kuba2k2/PiVI/hardware/v1.0/PiVI_v1.0-3d.jpg

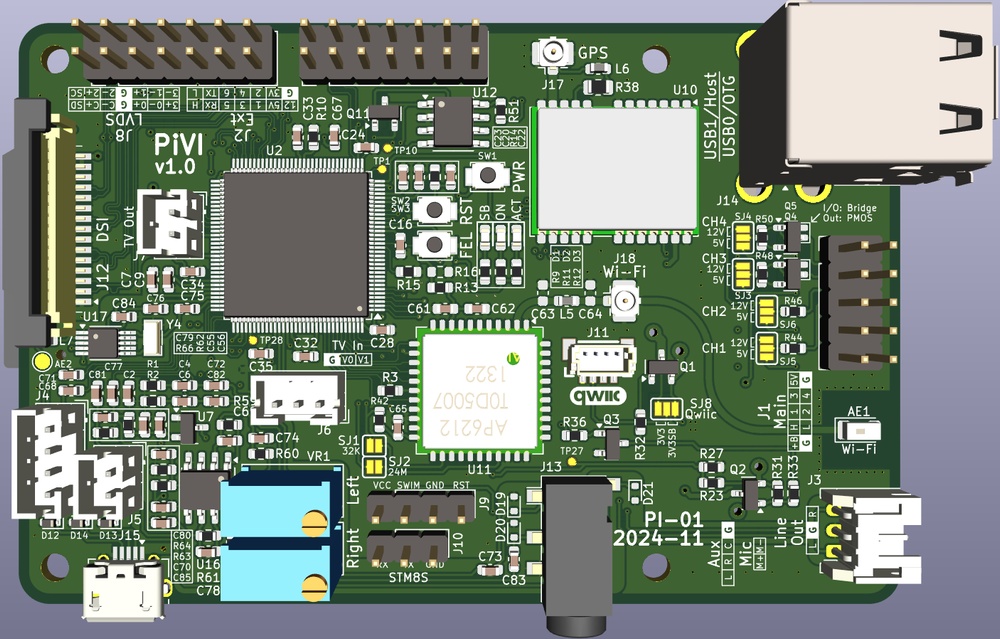
hardware/v1.0/PiVI_v1.0-3d.jpg
