kuba2k2/PiVI/hardware/v1.0/PiVI_v1.0-sch-sheet2-Power.png

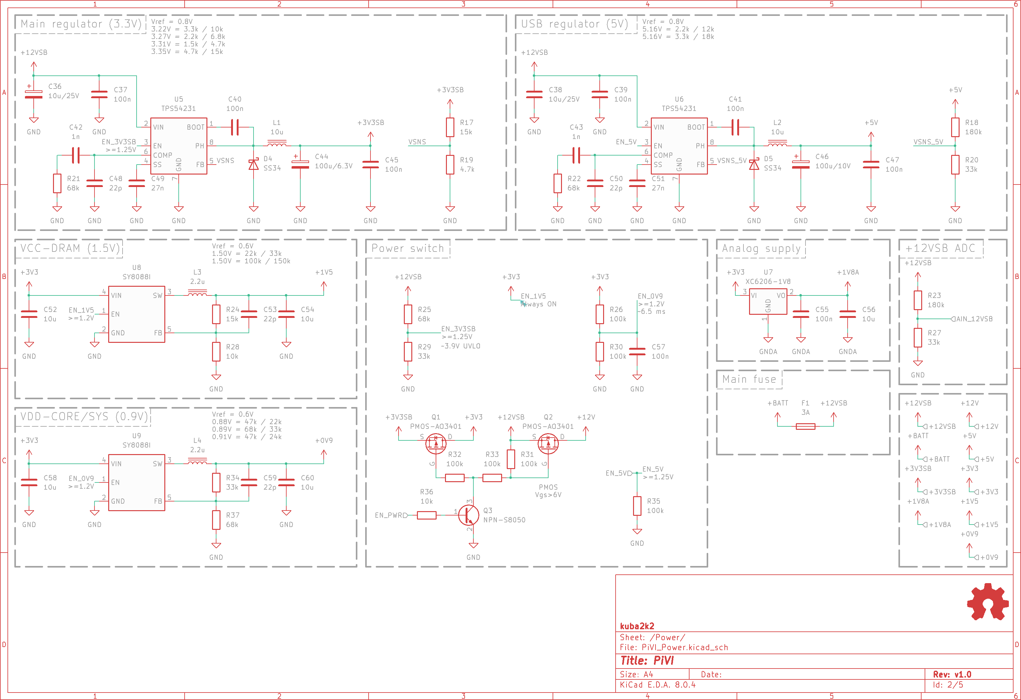
hardware/v1.0/PiVI_v1.0-sch-sheet2-Power.png
