kuba2k2/PiVI/hardware/v1.0/PiVI_v1.0-sch-sheet3-Comms.png

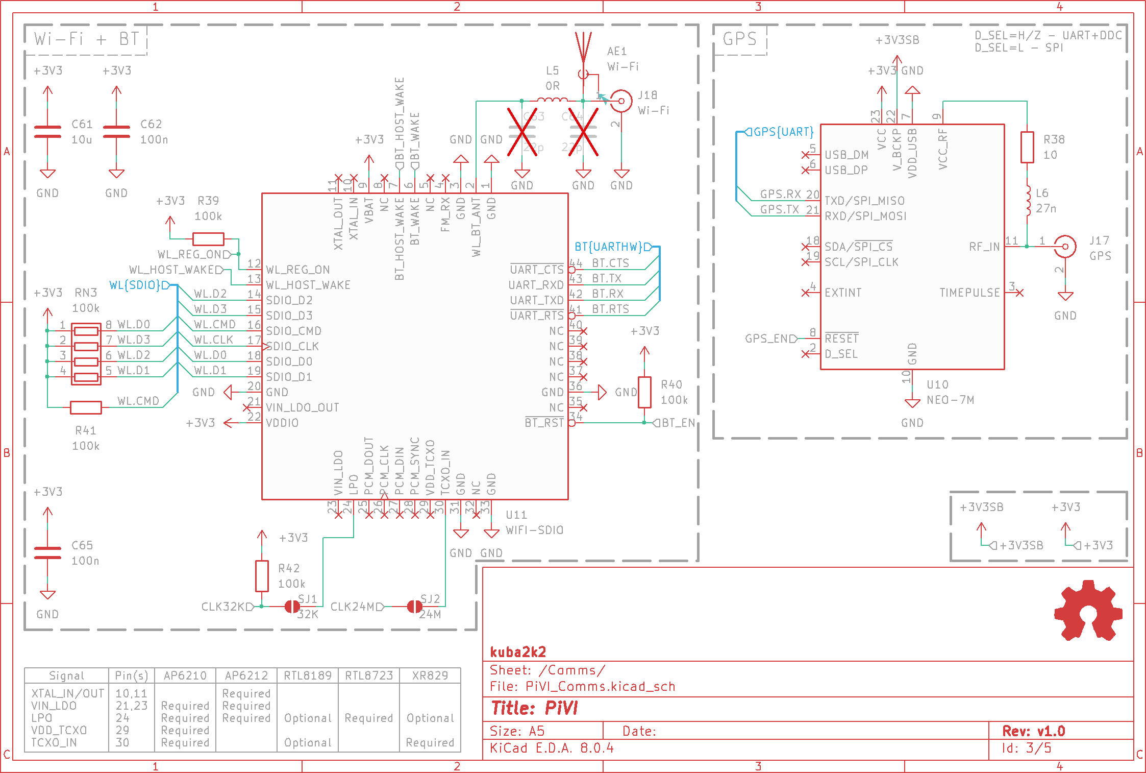
hardware/v1.0/PiVI_v1.0-sch-sheet3-Comms.png
