kuba2k2/PiVI/hardware/v1.0/PiVI_v1.0-sch-sheet5-AV.png

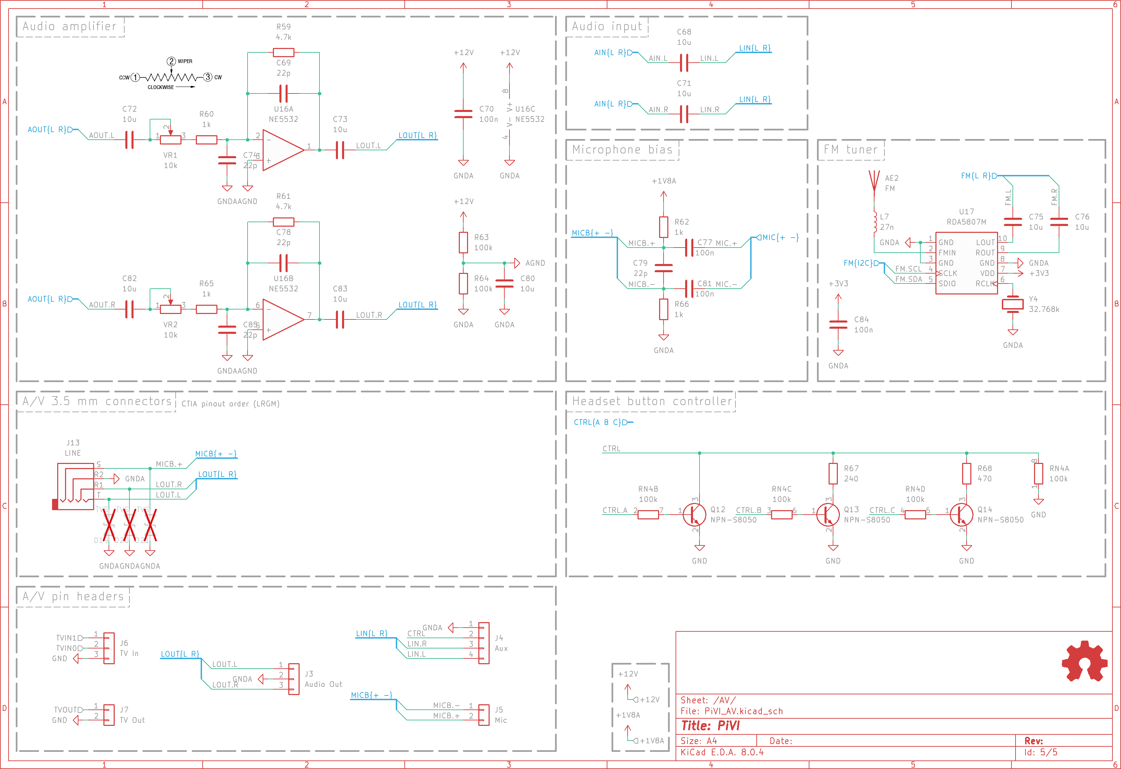
hardware/v1.0/PiVI_v1.0-sch-sheet5-AV.png
