kuba2k2/PiVI/hardware/PiVI.kicad_pcb

## KiCad design hardware/PiVI.kicad_pcb (2025-01-29)

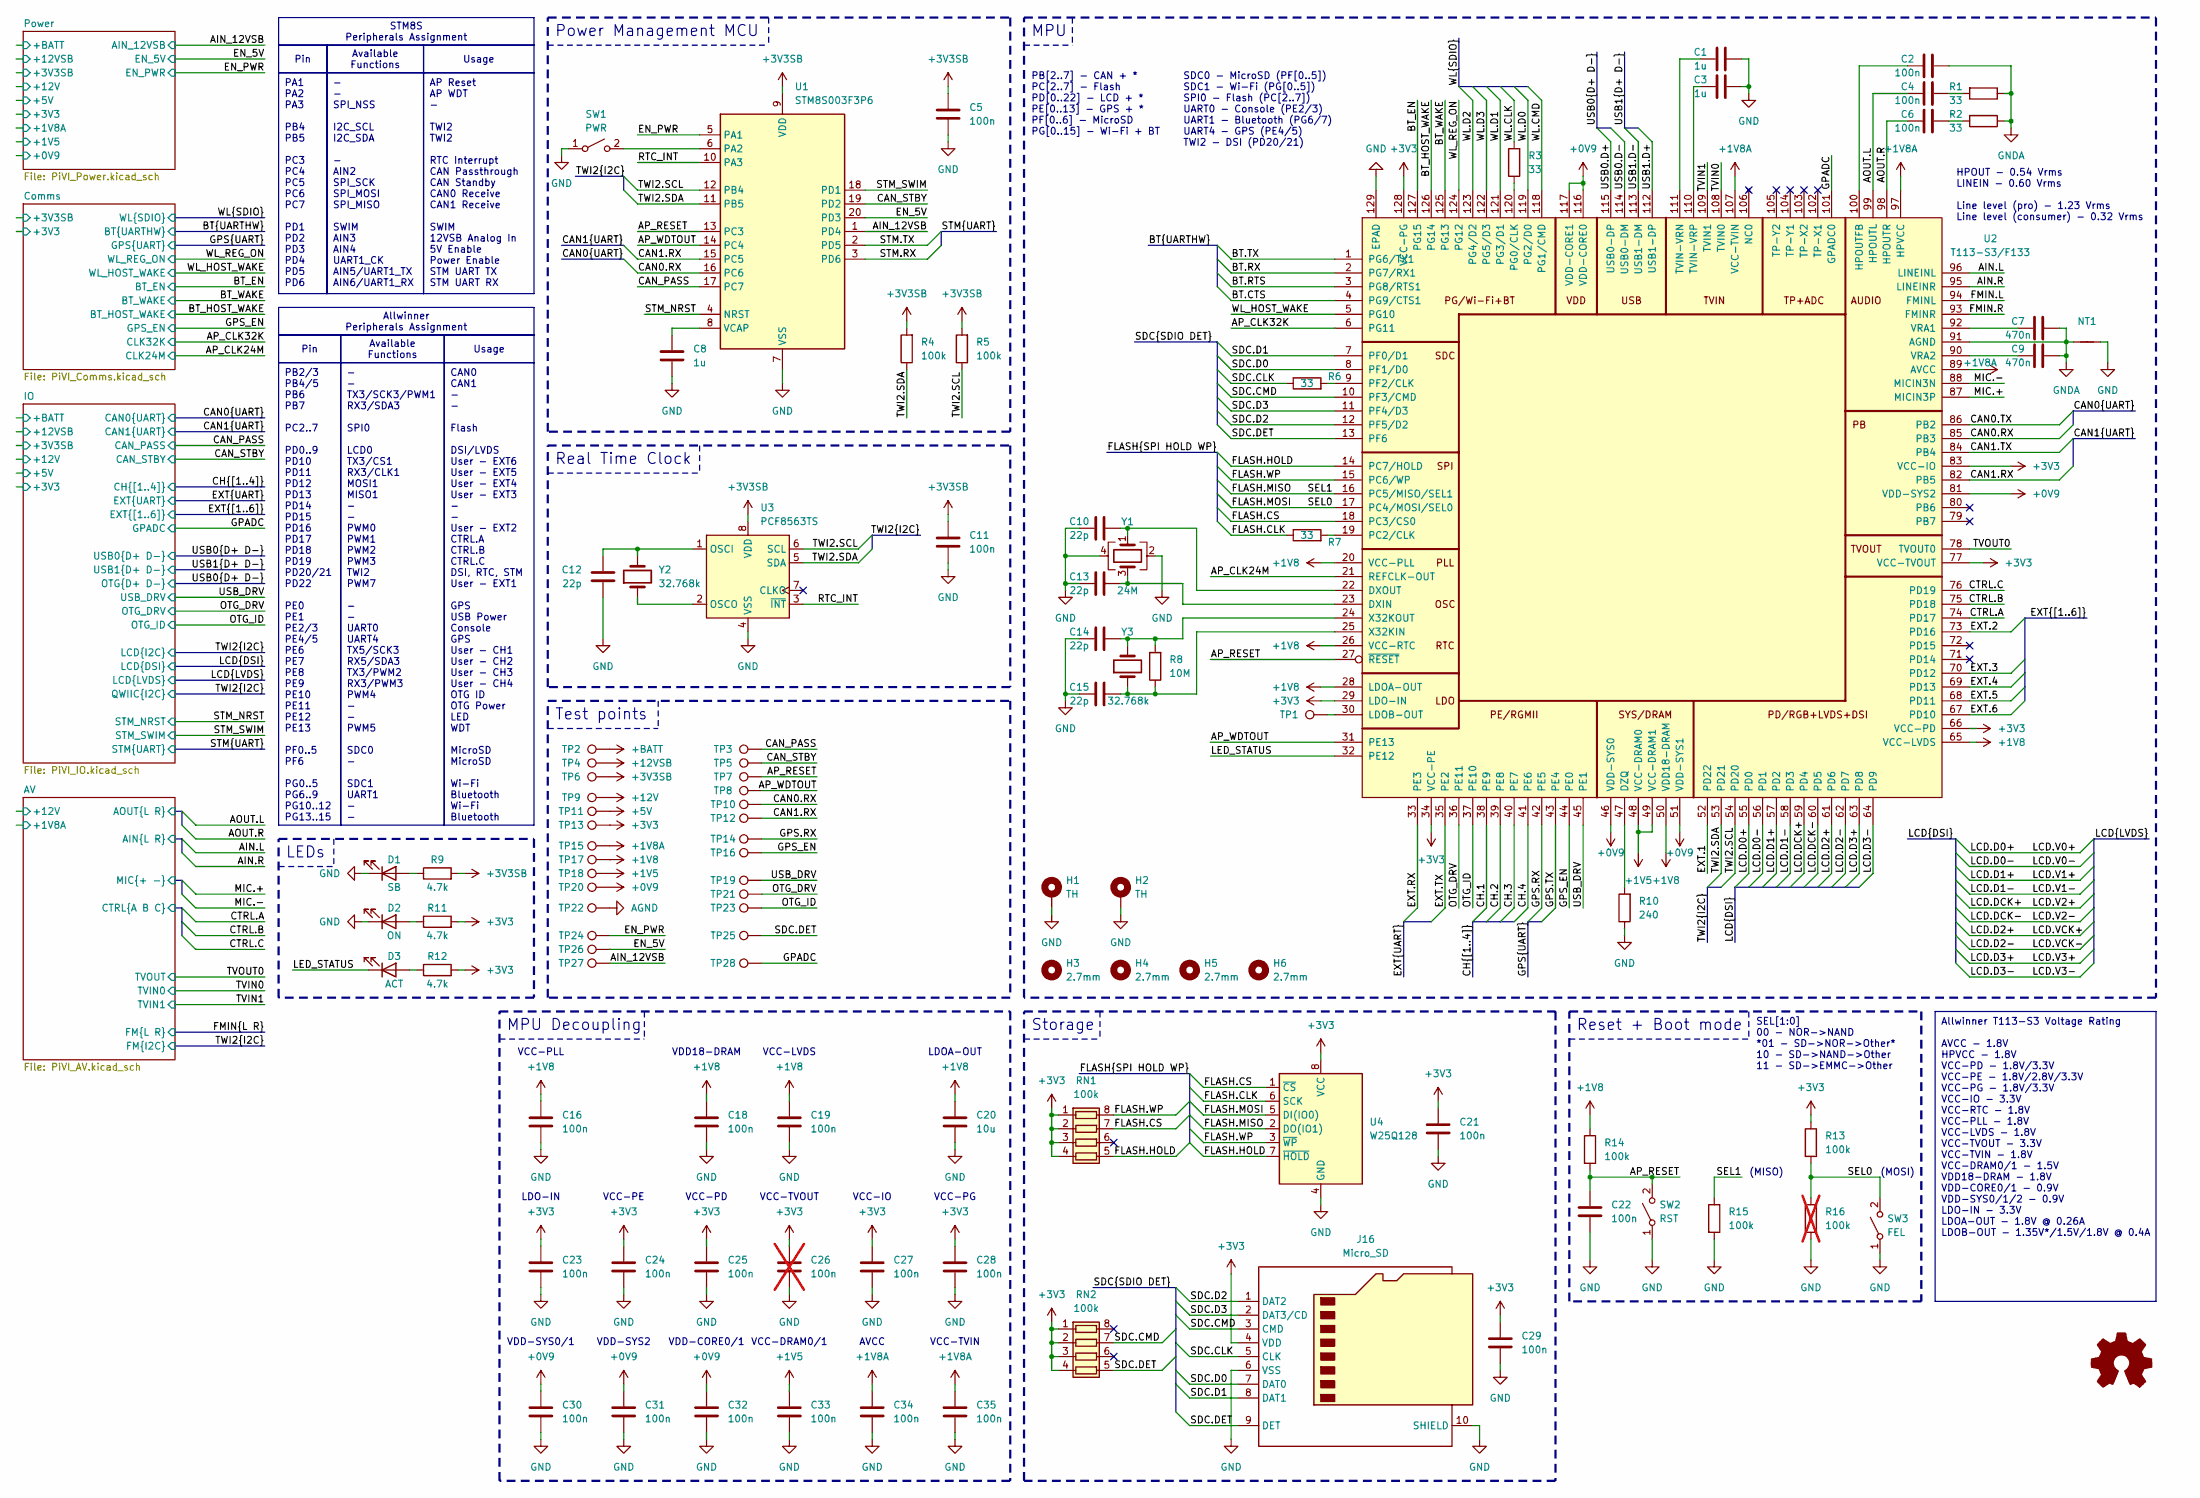
[picture p7: schematic PiVI.kicad_sch]

Parts:
C1, C3, C8: 1u; C_0603_1608Metric; MPN C29936
C2, C4, C5, C6, C11, C16, C18, C19, C21, C22, C23, C24, C25, C27, C28, C29, C30, C31, C32, C33, C34, C35: 100n; C_0603_1608Metric; MPN C14663
C7, C9: 470n; C_0603_1608Metric; MPN C1623
C10, C12, C13, C14, C15: 22p; C_0603_1608Metric; MPN C105620
C20: 10u; C_0603_1608Metric; MPN C19702
C26: 100n; C_0603_1608Metric; MPN C14663; not fitted
D1: SB; LED_0603_1608Metric; MPN C965800
D2: ON; LED_0603_1608Metric; MPN C965799
D3: ACT; LED_0603_1608Metric; MPN C965804
G1: Logo_Open_Hardware_Small; OSHW-Logo_7.5x8mm_SilkScreen; MPN N/A
H1, H2: TH; ThermalVia_1.5mm; MPN N/A
H3, H4, H5, H6: 2.7mm; MountingHole_2.7mm; MPN N/A
J16: Micro_SD; microSD_External_Pin; MPN C393941
NT1: NetTie-2_SMD_Pad0.5mm; MPN N/A
R1, R2, R3, R6, R7: 33; R_0603_1608Metric; MPN C2907154
R4, R5, R13, R14, R15: 100k; R_0603_1608Metric; MPN C2907088
R8: 10M; R_0603_1608Metric; MPN C2907090
R9, R11, R12: 4.7k; R_0603_1608Metric; MPN C2907166
R10: 240; R_0603_1608Metric; MPN C2907130
R16: 100k; R_0603_1608Metric; MPN C2907088; not fitted
RN1, RN2: 100k; R_Array_Convex_4x0603; MPN C173315
SW1: PWR; SW_SPST_B3U-1000P; MPN C455281
SW2: RST; SW_SPST_B3U-1000P; MPN C455281
SW3: FEL; SW_SPST_B3U-1000P; MPN C455281
TP1: LDOB-OUT; TestPoint-0.75mm; MPN N/A
TP2: +BATT; TestPoint-0.75mm; MPN N/A
TP3: CAN_PASS; TestPoint-0.75mm; MPN N/A
TP4: +12SB; TestPoint-0.75mm; MPN N/A
TP5: CAN_STBY; TestPoint-0.75mm; MPN N/A
TP6: +3V3SB; TestPoint-0.75mm; MPN N/A
TP7: AP_RESET; TestPoint-0.75mm; MPN N/A
TP8: AP_WDTOUT; TestPoint-0.75mm; MPN N/A
TP9: +12V; TestPoint-0.75mm; MPN N/A
TP10: CAN0.RX; TestPoint-0.75mm; MPN N/A
TP11: +5V; TestPoint-0.75mm; MPN N/A
TP12: CAN1.RX; TestPoint-0.75mm; MPN N/A
TP13: +3V3; TestPoint-0.75mm; MPN N/A
TP14: GPS.RX; TestPoint-0.75mm; MPN N/A
TP15: +1V8A; TestPoint-0.75mm; MPN N/A
TP16: GPS_EN; TestPoint-0.75mm; MPN N/A
TP17: +1V8; TestPoint-0.75mm; MPN N/A
TP18: +1V5; TestPoint-0.75mm; MPN N/A
TP19: USB_DRV; TestPoint-0.75mm; MPN N/A
TP20: +0V9; TestPoint-0.75mm; MPN N/A
TP21: OTG_DRV; TestPoint-0.75mm; MPN N/A
TP22: AGND; TestPoint-0.75mm; MPN N/A
TP23: OTG_ID; TestPoint-0.75mm; MPN N/A
TP24: EN_PWR; TestPoint-0.75mm; MPN N/A
TP25: SDC.DET; TestPoint-0.75mm; MPN N/A
TP26: EN_5V; TestPoint-0.75mm; MPN N/A
TP27: AIN_12SB; TestPoint-0.75mm; MPN N/A
TP28: GPADC; TestPoint-0.75mm; MPN N/A
U1: STM8S003F3P6; TSSOP-20_4.4x6.5mm_P0.65mm; MPN C52717
U2: T113-S3/F133; eLQFP-128_14x14mm_P0.4mm; MPN C5197687/C22438485
U3: PCF8563TS; MSOP-8_3x3mm_P0.65mm; MPN C269878
U4: W25Q128; SOIC-8_5.275x5.275mm_P1.27mm; MPN C97521
Y1: 24M; Crystal_SMD_3225-4Pin_3.2x2.5mm; MPN C70590
Y2, Y3: 32.768k; Crystal_SMD_3215-2Pin_3.2x1.5mm; MPN C5361379

Connections:
+0V9: C30.1, C31.1, C32.1, TP20.1, U2.46 (VDD-SYS0), U2.51 (VDD-SYS1), U2.81 (VDD-SYS2), U2.116 (VDD-CORE0), U2.117 (VDD-CORE1); also elsewhere on the board
+1V5: C33.1, TP18.1, U2.48 (VCC-DRAM0), U2.49 (VCC-DRAM1); also elsewhere on the board
+1V8: C16.1, C18.1, C19.1, C20.1, R14.1, TP17.1, U2.20 (VCC-PLL), U2.26 (VCC-RTC), U2.28 (LDOA-OUT), U2.50 (VDD18-DRAM), U2.65 (VCC-LVDS)
+1V8A: C34.1, C35.1, TP15.1, U2.89 (AVCC), U2.97 (HPVCC), U2.107 (VCC-TVIN); also elsewhere on the board
+3V3: C21.1, C23.1, C24.1, C25.1, C26.1, C27.1, C28.1, C29.1, J16.4 (VDD), R11.2, R12.2, R13.1, RN1.1 (R1.1), RN1.2 (R2.1), RN1.3 (R3.1), RN1.4 (R4.1), RN2.1 (R1.1), RN2.2 (R2.1), RN2.3 (R3.1), RN2.4 (R4.1), TP13.1, U2.29 (LDO-IN), U2.34 (VCC-PE), U2.66 (VCC-PD), U2.77 (VCC-TVOUT), U2.83 (VCC-IO), U2.128 (VCC-PG), U4.8 (VCC); also elsewhere on the board
+3V3SB: C5.1, C11.1, R4.2, R5.2, R9.2, TP6.1, U1.9 (VDD), U3.8 (VDD); also elsewhere on the board
+5V: TP11.1; also elsewhere on the board
+12V: TP9.1; also elsewhere on the board
+12VSB: TP4.1; also elsewhere on the board
+BATT: TP2.1; also elsewhere on the board
/AIN_12VSB: TP27.1, U1.1 (PD4); also elsewhere on the board
/AP_CLK24M: U2.21 (REFCLK-OUT); also elsewhere on the board
/AP_CLK32K: U2.6 (PG11); also elsewhere on the board
/AP_RESET: C22.2, R14.2, SW2.2 (B), TP7.1, U1.13 (PC3), U2.27 (~RESET)
/AP_WDTOUT: TP8.1, U1.14 (PC4), U2.31 (PE13)
/AV/AIN.L: U2.96 (LINEINL); also elsewhere on the board
/AV/AIN.R: U2.95 (LINEINR); also elsewhere on the board
/AV/AOUT.L: C4.2, U2.99 (HPOUTL); also elsewhere on the board
/AV/AOUT.R: C6.2, U2.98 (HPOUTR); also elsewhere on the board
/AV/CTRL.A: U2.74 (PD17); also elsewhere on the board
/AV/CTRL.B: U2.75 (PD18); also elsewhere on the board
/AV/CTRL.C: U2.76 (PD19); also elsewhere on the board
/AV/MIC.+: U2.87 (MICIN3P); also elsewhere on the board
/AV/MIC.-: U2.88 (MICIN3N); also elsewhere on the board
/BT.CTS: U2.4 (PG9/CTS1); also elsewhere on the board
/BT.RTS: U2.3 (PG8/RTS1); also elsewhere on the board
/BT.RX: U2.2 (PG7/RX1); also elsewhere on the board
/BT.TX: U2.1 (PG6/TX1); also elsewhere on the board
/BT_EN: U2.127 (PG15); also elsewhere on the board
/BT_HOST_WAKE: U2.126 (PG14); also elsewhere on the board
/BT_WAKE: U2.125 (PG13); also elsewhere on the board
/CAN0.RX: TP10.1, U1.16 (PC6), U2.85 (PB3); also elsewhere on the board
/CAN0.TX: U2.86 (PB2); also elsewhere on the board
/CAN1.RX: TP12.1, U1.15 (PC5), U2.82 (PB5); also elsewhere on the board
/CAN1.TX: U2.84 (PB4); also elsewhere on the board
/CAN_PASS: TP3.1, U1.17 (PC7); also elsewhere on the board
/CAN_STBY: TP5.1, U1.19 (PD2); also elsewhere on the board
/CH.1: U2.38 (PE9); also elsewhere on the board
/CH.2: U2.39 (PE8); also elsewhere on the board
/CH.3: U2.40 (PE7); also elsewhere on the board
/CH.4: U2.41 (PE6); also elsewhere on the board
/EN_5V: TP26.1, U1.20 (PD3); also elsewhere on the board
/EN_PWR: TP24.1, U1.5 (PA1); also elsewhere on the board
/EXT.1: U2.52 (PD22); also elsewhere on the board
/EXT.2: U2.73 (PD16); also elsewhere on the board
/EXT.3: U2.70 (PD12); also elsewhere on the board
/EXT.4: U2.69 (PD13); also elsewhere on the board
/EXT.5: U2.68 (PD11); also elsewhere on the board
/EXT.6: U2.67 (PD10); also elsewhere on the board
/EXT.RX: U2.33 (PE3); also elsewhere on the board
/EXT.TX: U2.35 (PE2); also elsewhere on the board
/FLASH.CLK: R7.1, U4.6 (SCK)
/FLASH.CS: RN1.7 (R2.2), U2.18 (PC3/CS0), U4.1 (~CS)
/FLASH.HOLD: RN1.5 (R4.2), U2.14 (PC7/HOLD), U4.7 (~HOLD)
/FLASH.MISO: R15.1, U2.16 (PC5/MISO/SEL1), U4.2 (DO(IO1))
/FLASH.MOSI: R13.2, R16.1, SW3.2 (B), U2.17 (PC4/MOSI/SEL0), U4.5 (DI(IO0))
/FLASH.WP: RN1.8 (R1.2), U2.15 (PC6/WP), U4.3 (~WP)
/FMIN.L: U2.94 (FMINL); also elsewhere on the board
/FMIN.R: U2.93 (FMINR); also elsewhere on the board
/GPADC: TP28.1, U2.101 (GPADC0)
/GPS.RX: TP14.1, U2.42 (PE5); also elsewhere on the board
/GPS.TX: U2.43 (PE4); also elsewhere on the board
/GPS_EN: TP16.1, U2.44 (PE0); also elsewhere on the board
/LCD.V0+: U2.55 (PD0); also elsewhere on the board
/LCD.V0-: U2.56 (PD1); also elsewhere on the board
/LCD.V1+: U2.57 (PD2); also elsewhere on the board
/LCD.V1-: U2.58 (PD3); also elsewhere on the board
/LCD.V2+: U2.59 (PD4); also elsewhere on the board
/LCD.V2-: U2.60 (PD5); also elsewhere on the board
/LCD.V3+: U2.63 (PD8); also elsewhere on the board
/LCD.V3-: U2.64 (PD9); also elsewhere on the board
/LCD.VCK+: U2.61 (PD6); also elsewhere on the board
/LCD.VCK-: U2.62 (PD7); also elsewhere on the board
/LED_STATUS: D3.1 (K), U2.32 (PE12)
/OTG_DRV: TP21.1, U2.36 (PE11); also elsewhere on the board
/OTG_ID: TP23.1, U2.37 (PE10); also elsewhere on the board
/RTC_INT: U1.10 (PA3), U3.3 (~INT)
/SDC.CLK: J16.5 (CLK), R6.1
/SDC.CMD: J16.3 (CMD), RN2.7 (R2.2), U2.10 (PF3/CMD)
/SDC.D0: J16.7 (DAT0), U2.8 (PF1/D0)
/SDC.D1: J16.8 (DAT1), U2.7 (PF0/D1)
/SDC.D2: J16.1 (DAT2), U2.12 (PF5/D2)
/SDC.D3: J16.2 (DAT3/CD), U2.11 (PF4/D3)
/SDC.DET: J16.9 (DET), RN2.5 (R4.2), TP25.1, U2.13 (PF6)
/STM.RX: U1.3 (PD6); also elsewhere on the board
/STM.TX: U1.2 (PD5); also elsewhere on the board
/STM_NRST: U1.4 (NRST); also elsewhere on the board
/STM_SWIM: U1.18 (PD1); also elsewhere on the board
/TVIN0: U2.108 (TVIN0); also elsewhere on the board
/TVIN1: U2.109 (TVIN1); also elsewhere on the board
/TVOUT0: U2.78 (TVOUT0); also elsewhere on the board
/USB1.D+: U2.112 (USB1-DP); also elsewhere on the board
/USB1.D-: U2.113 (USB1-DM); also elsewhere on the board
/USB_DRV: TP19.1, U2.45 (PE1); also elsewhere on the board
/WL.CLK: R3.2; also elsewhere on the board
/WL.CMD: U2.118 (PG1/CMD); also elsewhere on the board
/WL.D0: U2.119 (PG2/D0); also elsewhere on the board
/WL.D1: U2.121 (PG3/D1); also elsewhere on the board
/WL.D2: U2.123 (PG4/D2); also elsewhere on the board
/WL.D3: U2.122 (PG5/D3); also elsewhere on the board
/WL_HOST_WAKE: U2.5 (PG10); also elsewhere on the board
/WL_REG_ON: U2.124 (PG12); also elsewhere on the board
AGND: TP22.1; also elsewhere on the board
GND: C1.1, C3.1, C5.2, C8.1, C10.1, C11.2, C12.1, C13.1, C14.1, C15.1, C16.2, C18.2, C19.2, C20.2, C21.2, C22.1, C23.2, C24.2, C25.2, C26.2, C27.2, C28.2, C29.2, C30.2, C31.2, C32.2, C33.2, C34.2, C35.2, D1.1 (K), D2.1 (K), H1.1, H2.1, J16.6 (VSS), J16.10 (SHIELD), NT1.2, R10.1, R15.2, R16.2, SW1.1 (A), SW2.1 (A), SW3.1 (A), U1.7 (VSS), U2.129 (EPAD), U3.4 (VSS), U4.4 (GND), Y1.2, Y1.4; also elsewhere on the board
GNDA: C2.1, C7.2, C9.2, NT1.1, R1.1, R2.1, U2.91 (AGND); also elsewhere on the board
unnamed: C4.1, R1.2
unnamed: C6.1, R2.2
unnamed: D1.2 (A), R9.1
unnamed: D2.2 (A), R11.1
unnamed: D3.2 (A), R12.1
unnamed: SW1.2 (B), U1.6 (PA2)
unnamed: C8.2, U1.8 (VCAP)
unnamed: C13.2, U2.23 (DXIN), Y1.3
unnamed: C10.2, U2.22 (DXOUT), Y1.1
unnamed: R10.2, U2.47 (DZQ)
unnamed: C2.2, U2.100 (HPOUTFB)
unnamed: TP1.1, U2.30 (LDOB-OUT)
unnamed: R7.2, U2.19 (PC2/CLK)
unnamed: R6.2, U2.9 (PF2/CLK)
unnamed: R3.1, U2.120 (PG0/CLK)
unnamed: C1.2, U2.111 (TVIN-VRN)
unnamed: C3.2, U2.110 (TVIN-VRP)
unnamed: C7.1, U2.92 (VRA1)
unnamed: C9.1, U2.90 (VRA2)
unnamed: C15.2, R8.1, U2.25 (X32KIN), Y3.1
unnamed: C14.2, R8.2, U2.24 (X32KOUT), Y3.2
unnamed: C12.2, U3.1 (OSCI), Y2.2
unnamed: U3.2 (OSCO), Y2.1

Notes on the sheet:
Pin
Usage
- - TX3/SCK3/PWM1 RX3/SDA3 SPI0 LCD0 TX3/CS1 RX3/CLK1 MOSI1 MISO1 - - PWM0 PWM1 PWM2 PWM3 TWI2 PWM7 - - UART0 UART4 TX5/SCK3 RX5/SDA3 TX3/PWM2 RX3/PWM3 PWM4 - - PWM5 SDC0 - SDC1 UART1 - -
AP Reset AP WDT - TWI2 TWI2 RTC Interrupt CAN Passthrough CAN Standby CAN0 Receive CAN1 Receive SWIM 12VSB Analog In 5V Enable Power Enable STM UART TX STM UART RX
- - SPI_NSS I2C_SCL I2C_SDA - AIN2 SPI_SCK SPI_MOSI SPI_MISO SWIM AIN3 AIN4 UART1_CK AIN5/UART1_TX AIN6/UART1_RX
Allwinner T113-S3 Voltage Rating AVCC - 1.8V HPVCC - 1.8V VCC-PD - 1.8V/3.3V VCC-PE - 1.8V/2.8V/3.3V VCC-PG - 1.8V/3.3V VCC-IO - 3.3V VCC-RTC - 1.8V VCC-PLL - 1.8V VCC-LVDS - 1.8V VCC-TVOUT - 3.3V VCC-TVIN - 1.8V VCC-DRAM0/1 - 1.5V VDD18-DRAM - 1.8V VDD-CORE0/1 - 0.9V VDD-SYS0/1/2 - 0.9V LDO-IN - 3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
Available Functions
PA1 PA2 PA3 PB4 PB5 PC3 PC4 PC5 PC6 PC7 PD1 PD2 PD3 PD4 PD5 PD6
PB2/3 PB4/5 PB6 PB7 PC2..7 PD0..9 PD10 PD11 PD12 PD13 PD14 PD15 PD16 PD17 PD18 PD19 PD20/21 PD22 PE0 PE1 PE2/3 PE4/5 PE6 PE7 PE8 PE9 PE10 PE11 PE12 PE13 PF0..5 PF6 PG0..5 PG6..9 PG10..12 PG13..15
CAN0 CAN1 - - Flash DSI/LVDS User - EXT6 User - EXT5 User - EXT4 User - EXT3 - - User - EXT2 CTRL.A CTRL.B CTRL.C DSI, RTC, STM User - EXT1 GPS USB Power Console GPS User - CH1 User - CH2 User - CH3 User - CH4 OTG ID OTG Power LED WDT MicroSD MicroSD Wi-Fi Bluetooth Wi-Fi Bluetooth
STM8S Peripherals Assignment
Allwinner Peripherals Assignment
(MOSI)
SDC0 - MicroSD (PF[0..5]) SDC1 - Wi-Fi (PG[0..5]) SPI0 - Flash (PC[2..7]) UART0 - Console (PE2/3) UART1 - Bluetooth (PG6/7) UART4 - GPS (PE4/5) TWI2 - DSI (PD20/21)
VCC-DRAM0/1
VDD-SYS2
VCC-PE
VCC-PD
LDO-IN
HPOUT - 0.54 Vrms LINEIN - 0.60 Vrms Line level (pro) - 1.23 Vrms Line level (consumer) - 0.32 Vrms
Power Management MCU
SEL[1:0] 00 - NOR->NAND *01 - SD->NOR->Other* 10 - SD->NAND->Other 11 - SD->EMMC->Other
VCC-IO
Storage
VDD-SYS0/1
LEDs
Reset + Boot mode
Real Time Clock
VDD-CORE0/1
VCC-PLL
VCC-TVOUT
VCC-PG
PB[2..7] - CAN + * PC[2..7] - Flash PD[0..22] - LCD + * PE[0..13] - GPS + * PF[0..6] - MicroSD PG[0..15] - Wi-Fi + BT
(MISO)
MPU Decoupling
VCC-LVDS
LDOA-OUT
VCC-TVIN
MPU
Test points
AVCC
VDD18-DRAM

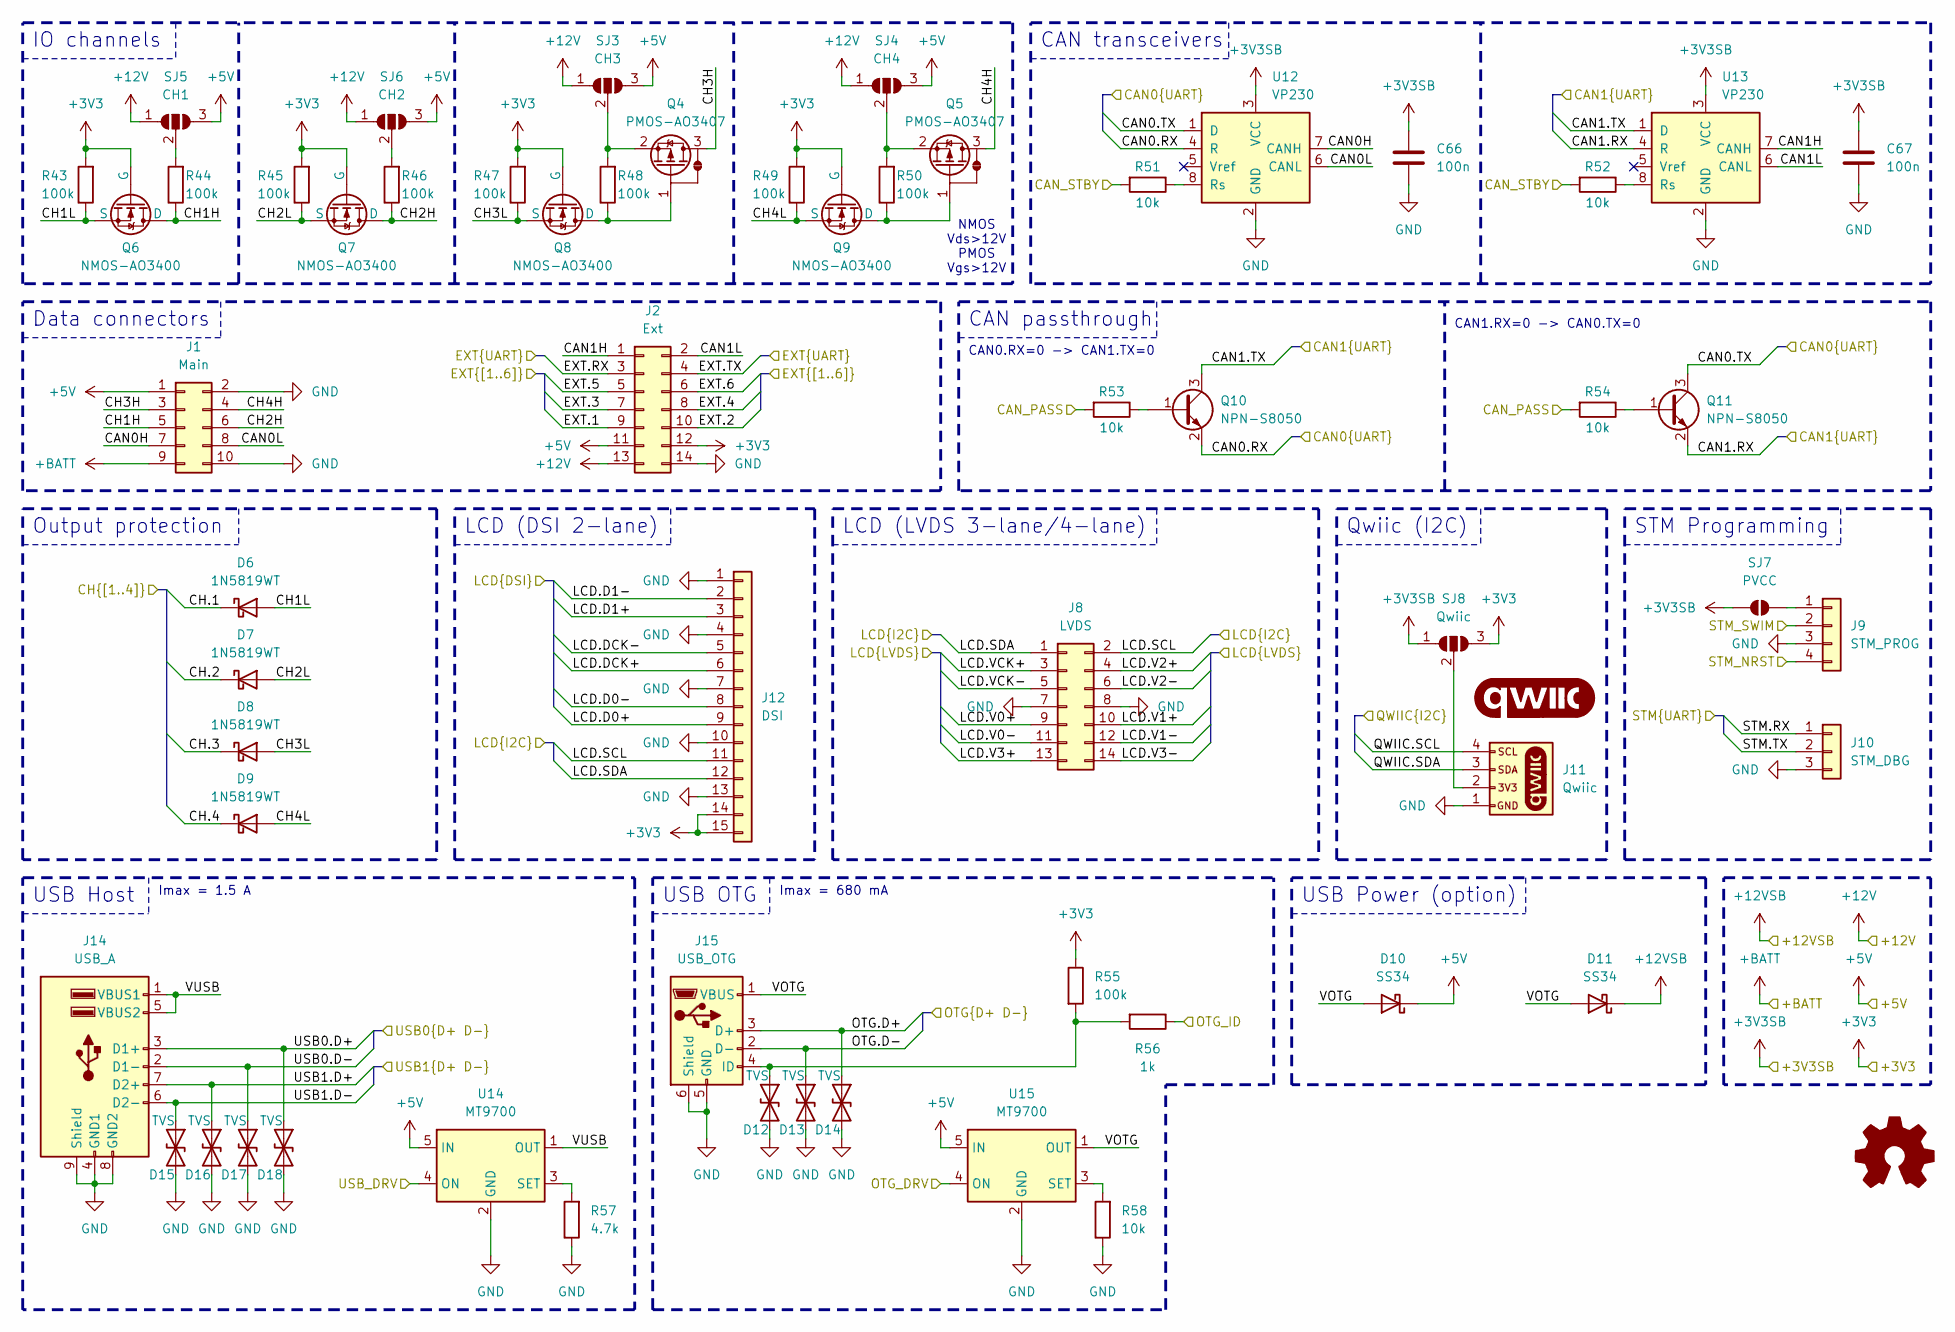
[picture p8: schematic PiVI_IO.kicad_sch, PiVI]

Parts:
C66, C67: 100n; C_0603_1608Metric; MPN C14663
D6, D7, D8, D9: 1N5819WT; D_SOD-523; MPN C5451630
D10, D11: SS34; D_SMA; MPN C2836396
D12, D13, D14, D15, D16, D17, D18: TVS; D_SOD-523; MPN C3008120
G2: qwiic_Logo; qwiic_5.5mm; MPN N/A
J1: Main; PinHeader_2x05_P2.54mm_Vertical; MPN C19190512/C19190511
J2: Ext; PinHeader_2x07_P2.54mm_Vertical; MPN C19190512/C19190511
J8: LVDS; PinHeader_2x07_P2.54mm_Vertical; MPN C19190512/C19190511
J9: STM_PROG; PinHeader_1x04_P2.54mm_Vertical; MPN C2337
J10: STM_DBG; PinHeader_1x03_P2.54mm_Vertical; MPN C2337
J11: Qwiic; JST_SMD_1.0mm-4_Vertical; MPN C160390
J12: DSI; TE-1-1734248-5; MPN C2922285
J14: USB_A; USB_A_CUI_UJ2-ADH-TH_Horizontal_Stacked; MPN C456021
J15: USB_OTG; USB_Micro-B_MicroXNJ; MPN C404969
Q4, Q5: PMOS-AO3407; SOT-23-GDPASS; MPN C347478
Q6, Q7, Q8, Q9: NMOS-AO3400; SOT-23; MPN C20628874
Q10, Q11: NPN-S8050; SOT-23; MPN C181158
R43, R44, R45, R46, R47, R48, R49, R50, R55: 100k; R_0603_1608Metric; MPN C2907088
R51, R52, R53, R54, R58: 10k; R_0603_1608Metric; MPN C2930027
R56: 1k; R_0603_1608Metric; MPN C2907113
R57: 4.7k; R_0603_1608Metric; MPN C2907166
SJ3: CH3; Jumper_3_NO; MPN N/A
SJ4: CH4; Jumper_3_NO; MPN N/A
SJ5: CH1; Jumper_3_NO; MPN N/A
SJ6: CH2; Jumper_3_NO; MPN N/A
SJ7: PVCC; Jumper_2_NO; MPN N/A
SJ8: Qwiic; Jumper_3_NO; MPN N/A
U12, U13: VP230; SOIC-8_3.9x4.9mm_P1.27mm; MPN C12084
U14, U15: MT9700; SOT-23-5; MPN C89855

Connections:
+3V3: J2.12, J12.14, J12.15, Q6.1 (G), Q7.1 (G), Q8.1 (G), Q9.1 (G), R43.2, R45.2, R47.2, R49.2, R55.1, SJ8.3 (B); also elsewhere on the board
+3V3SB: C66.1, C67.1, SJ7.1 (A), SJ8.1 (A), U12.3 (VCC), U13.3 (VCC); also elsewhere on the board
+5V: D10.1 (K), J1.1, J2.11, SJ3.3 (B), SJ4.3 (B), SJ5.3 (B), SJ6.3 (B), U14.5 (IN), U15.5 (IN); also elsewhere on the board
+12V: J2.13, SJ3.1 (A), SJ4.1 (A), SJ5.1 (A), SJ6.1 (A); also elsewhere on the board
+12VSB: D11.1 (K); also elsewhere on the board
+BATT: J1.9; also elsewhere on the board
/CAN0.RX: Q10.2 (E), U12.4 (R); also elsewhere on the board
/CAN0.TX: Q11.3 (C), U12.1 (D); also elsewhere on the board
/CAN1.RX: Q11.2 (E), U13.4 (R); also elsewhere on the board
/CAN1.TX: Q10.3 (C), U13.1 (D); also elsewhere on the board
/CAN_PASS: R53.2, R54.2; also elsewhere on the board
/CAN_STBY: R51.2, R52.2; also elsewhere on the board
/CH.1: D6.1 (K); also elsewhere on the board
/CH.2: D7.1 (K); also elsewhere on the board
/CH.3: D8.1 (K); also elsewhere on the board
/CH.4: D9.1 (K); also elsewhere on the board
/EXT.1: J2.9; also elsewhere on the board
/EXT.2: J2.10; also elsewhere on the board
/EXT.3: J2.7; also elsewhere on the board
/EXT.4: J2.8; also elsewhere on the board
/EXT.5: J2.5; also elsewhere on the board
/EXT.6: J2.6; also elsewhere on the board
/EXT.RX: J2.3; also elsewhere on the board
/EXT.TX: J2.4; also elsewhere on the board
/IO/CAN0H: J1.7, U12.7 (CANH)
/IO/CAN0L: J1.8, U12.6 (CANL)
/IO/CAN1H: J2.1, U13.7 (CANH)
/IO/CAN1L: J2.2, U13.6 (CANL)
/IO/CH1H: J1.5, Q6.3 (D), R44.1
/IO/CH1L: D6.2 (A), Q6.2 (S), R43.1
/IO/CH2H: J1.6, Q7.3 (D), R46.1
/IO/CH2L: D7.2 (A), Q7.2 (S), R45.1
/IO/CH3H: J1.3, Q4.3 (D)
/IO/CH3L: D8.2 (A), Q8.2 (S), R47.1
/IO/CH4H: J1.4, Q5.3 (D)
/IO/CH4L: D9.2 (A), Q9.2 (S), R49.1
/IO/VOTG: D10.2 (A), D11.2 (A), J15.1 (VBUS), U15.1 (OUT)
/IO/VUSB: J14.1 (VBUS1), J14.5 (VBUS2), U14.1 (OUT)
/LCD.V0+: J8.9, J12.9; also elsewhere on the board
/LCD.V0-: J8.11, J12.8; also elsewhere on the board
/LCD.V1+: J8.10, J12.3; also elsewhere on the board
/LCD.V1-: J8.12, J12.2; also elsewhere on the board
/LCD.V2+: J8.4, J12.6; also elsewhere on the board
/LCD.V2-: J8.6, J12.5; also elsewhere on the board
/LCD.V3+: J8.13; also elsewhere on the board
/LCD.V3-: J8.14; also elsewhere on the board
/LCD.VCK+: J8.3; also elsewhere on the board
/LCD.VCK-: J8.5; also elsewhere on the board
/OTG_DRV: U15.4 (ON); also elsewhere on the board
/OTG_ID: R56.1; also elsewhere on the board
/STM.RX: J10.1; also elsewhere on the board
/STM.TX: J10.2; also elsewhere on the board
/STM_NRST: J9.4; also elsewhere on the board
/STM_SWIM: J9.2; also elsewhere on the board
/USB1.D+: D16.1 (A1), J14.7 (D2+); also elsewhere on the board
/USB1.D-: D15.1 (A1), J14.6 (D2-); also elsewhere on the board
/USB_DRV: U14.4 (ON); also elsewhere on the board
GND: C66.2, C67.2, D12.2 (A2), D13.2 (A2), D14.2 (A2), D15.2 (A2), D16.2 (A2), D17.2 (A2), D18.2 (A2), J1.2, J1.10, J2.14, J8.7, J8.8, J9.3, J10.3, J11.1, J12.1, J12.4, J12.7, J12.10, J12.13, J14.4 (GND1), J14.8 (GND2), J14.9 (Shield), J15.5 (GND), J15.6 (Shield), R57.1, R58.1, U12.2 (GND), U13.2 (GND), U14.2 (GND), U15.2 (GND); also elsewhere on the board
unnamed: D12.1 (A1), J15.4 (ID), R55.2, R56.2
unnamed: J9.1, SJ7.2 (B)
unnamed: J11.2, SJ8.2 (C)
unnamed: Q4.1 (G), Q8.3 (D), R48.1
unnamed: Q4.2 (S), R48.2, SJ3.2 (C)
unnamed: Q5.1 (G), Q9.3 (D), R50.1
unnamed: Q5.2 (S), R50.2, SJ4.2 (C)
unnamed: Q10.1 (B), R53.1
unnamed: Q11.1 (B), R54.1
unnamed: R44.2, SJ5.2 (C)
unnamed: R46.2, SJ6.2 (C)
unnamed: R51.1, U12.8 (Rs)
unnamed: R52.1, U13.8 (Rs)
unnamed: R57.2, U14.3 (SET)
unnamed: R58.2, U15.3 (SET)

Notes on the sheet:
USB Host
Imax = 680 mA
LCD (LVDS 3-lane/4-lane)
CAN transceivers
Data connectors
USB OTG
CAN1.RX=0 -> CAN0.TX=0
Imax = 1.5 A
LCD (DSI 2-lane)
STM Programming
Output protection
IO channels
NMOS Vds>12V PMOS Vgs>12V
CAN passthrough
Qwiic (I2C)
CAN0.RX=0 -> CAN1.TX=0
USB Power (option)

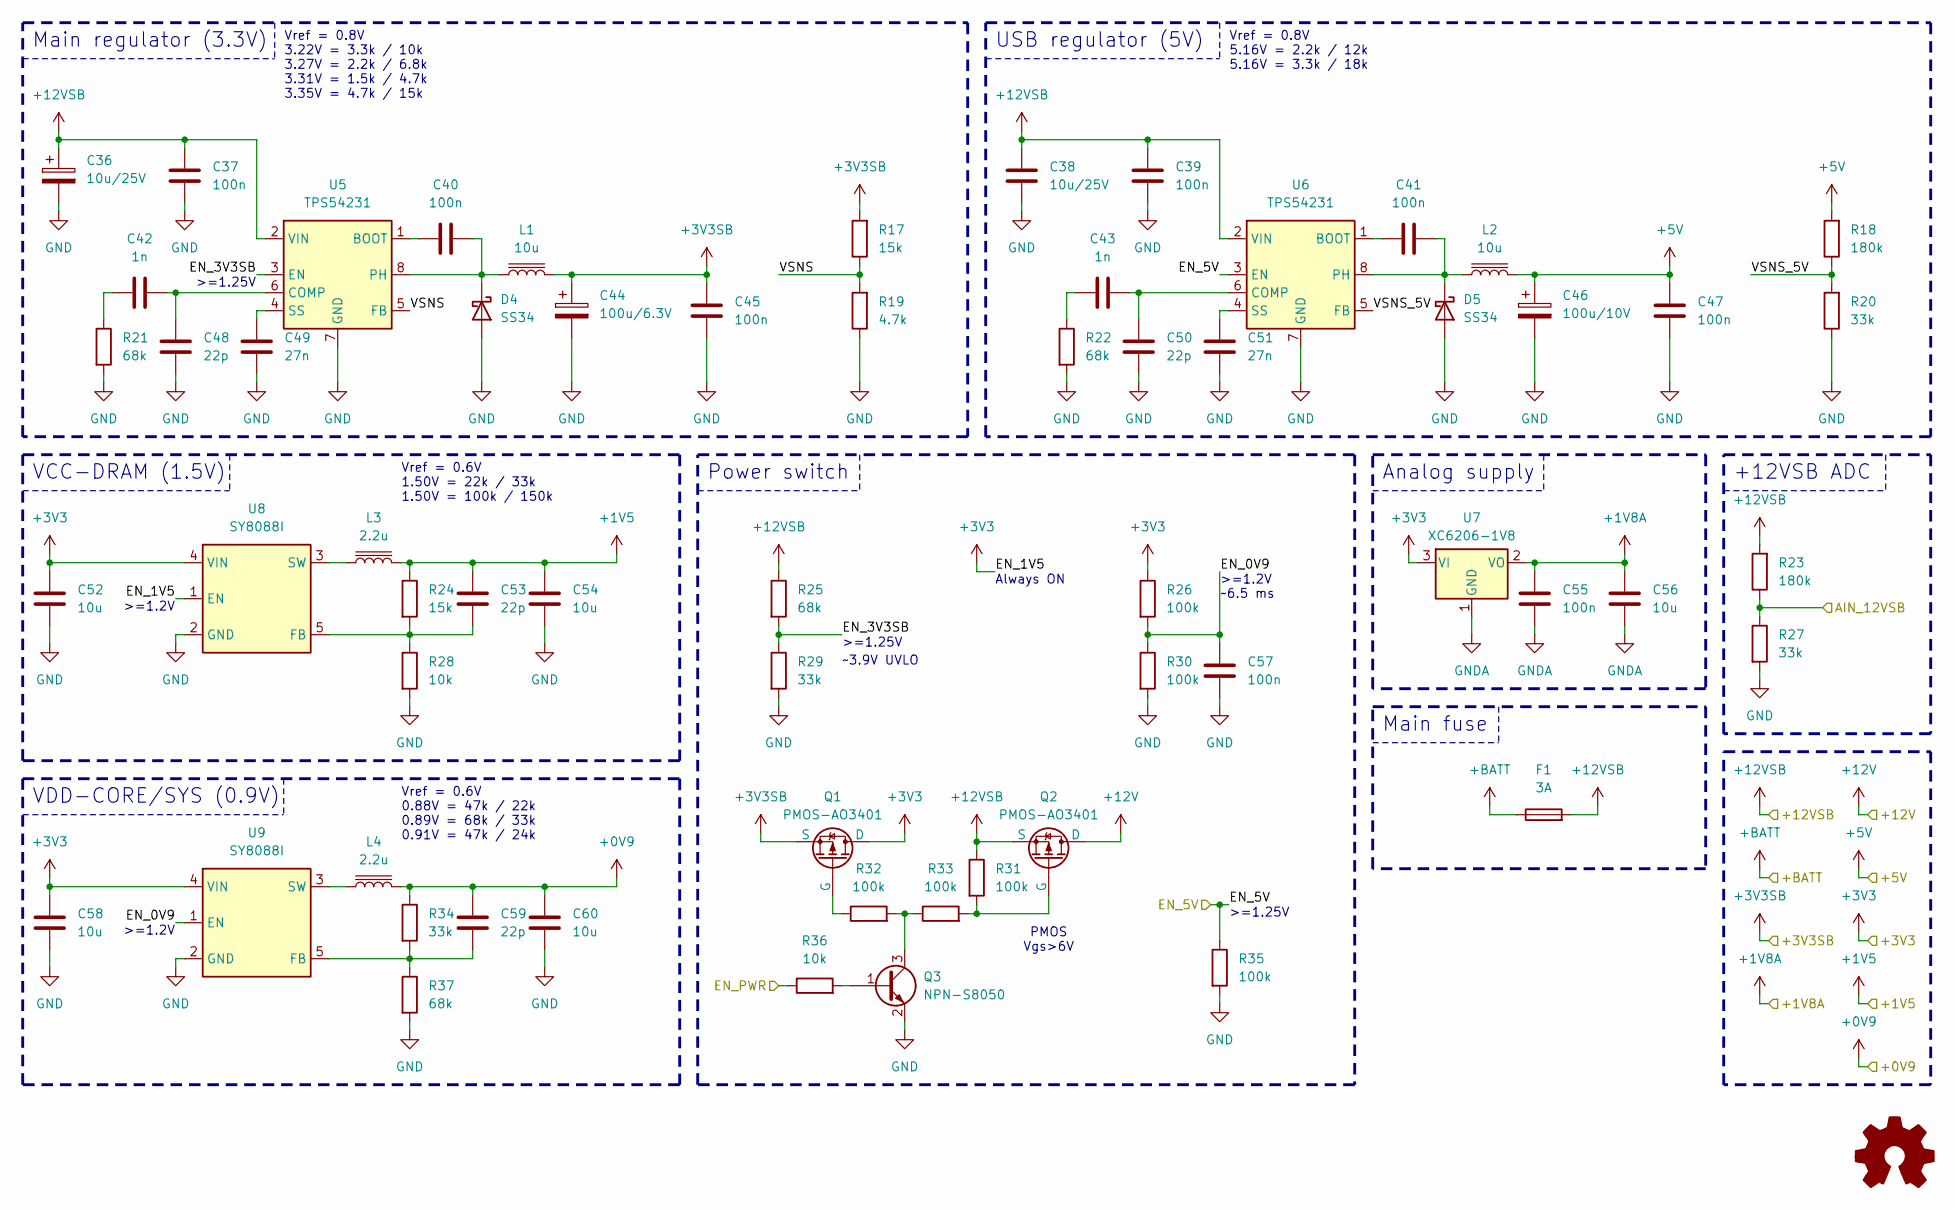
[picture p9: schematic PiVI_Power.kicad_sch, PiVI]

Parts:
C36: 10u/25V; CP_EIA-3528-21_Kemet-B; MPN C119050
C37, C39, C40, C41, C45, C47, C55, C57: 100n; C_0603_1608Metric; MPN C14663
C38: 10u/25V; C_0805_2012Metric; MPN C15850
C42, C43: 1n; C_0603_1608Metric; MPN C100040
C44: 100u/6.3V; CP_EIA-3528-21_Kemet-B; MPN C129289
C46: 100u/10V; CP_EIA-3528-21_Kemet-B; MPN C129567
C48, C50, C53, C59: 22p; C_0603_1608Metric; MPN C105620
C49, C51: 27n; C_0603_1608Metric; MPN C107086
C52, C54, C56, C58, C60: 10u; C_0603_1608Metric; MPN C19702
D4, D5: SS34; D_SMA; MPN C2836396
F1: 3A; Fuse_1206_3216Metric; MPN C14165
L1, L2: 10u; L_Changjiang_FNR4020S; MPN C602032
L3, L4: 2.2u; L_Sunlord_SWPA3015S; MPN C43389
Q1, Q2: PMOS-AO3401; SOT-23; MPN C20628875
Q3: NPN-S8050; SOT-23; MPN C181158
R17, R24: 15k; R_0603_1608Metric; MPN C2907104
R18, R23: 180k; R_0603_1608Metric; MPN C2907109
R19: 4.7k; R_0603_1608Metric; MPN C2907166
R20, R27, R29, R34: 33k; R_0603_1608Metric; MPN C2907153
R21, R22, R25, R37: 68k; R_0603_1608Metric; MPN C2907196
R26, R30, R31, R32, R33, R35: 100k; R_0603_1608Metric; MPN C2907088
R28, R36: 10k; R_0603_1608Metric; MPN C2930027
U5, U6: TPS54231; SOIC-8_3.9x4.9mm_P1.27mm; MPN C28023
U7: XC6206-1V8; SOT-23-3; MPN C5252894
U8, U9: SY8088I; TSOT-23-5; MPN C479072

Connections:
+0V9: C59.1, C60.1, L4.2, R34.1; also elsewhere on the board
+1V5: C53.1, C54.1, L3.2, R24.1; also elsewhere on the board
+1V8A: C55.1, C56.1, U7.2 (VO); also elsewhere on the board
+3V3: C52.1, C58.1, Q1.3 (D), R26.1, U7.3 (VI), U8.1 (EN), U8.4 (VIN), U9.4 (VIN); also elsewhere on the board
+3V3SB: C44.1, C45.1, L1.2, Q1.2 (S), R17.2; also elsewhere on the board
+5V: C46.1, C47.1, L2.2, R18.2; also elsewhere on the board
+12V: Q2.3 (D); also elsewhere on the board
+12VSB: C36.1, C37.1, C38.1, C39.1, F1.2, Q2.2 (S), R23.2, R25.1, R31.1, U5.2 (VIN), U6.2 (VIN); also elsewhere on the board
+BATT: F1.1; also elsewhere on the board
/AIN_12VSB: R23.1, R27.1; also elsewhere on the board
/EN_5V: R35.1, U6.3 (EN); also elsewhere on the board
/EN_PWR: R36.1; also elsewhere on the board
/Power/EN_0V9: C57.1, R26.2, R30.1, U9.1 (EN)
/Power/EN_3V3SB: R25.2, R29.1, U5.3 (EN)
/Power/VSNS: R17.1, R19.2, U5.5 (FB)
/Power/VSNS_5V: R18.1, R20.2, U6.5 (FB)
GND: C36.2, C37.2, C38.2, C39.2, C44.2, C45.2, C46.2, C47.2, C48.2, C49.2, C50.2, C51.2, C52.2, C54.2, C57.2, C58.2, C60.2, D4.2 (A), D5.2 (A), Q3.2 (E), R19.1, R20.1, R21.2, R22.2, R27.2, R28.2, R29.2, R30.2, R35.2, R37.2, U5.7 (GND), U6.7 (GND), U8.2 (GND), U9.2 (GND); also elsewhere on the board
GNDA: C55.2, C56.2, U7.1 (GND); also elsewhere on the board
unnamed: C42.2, R21.1
unnamed: C43.2, R22.1
unnamed: C40.2, D4.1 (K), L1.1, U5.8 (PH)
unnamed: C41.2, D5.1 (K), L2.1, U6.8 (PH)
unnamed: Q1.1 (G), R32.1
unnamed: Q2.1 (G), R31.2, R33.2
unnamed: Q3.1 (B), R36.2
unnamed: Q3.3 (C), R32.2, R33.1
unnamed: C40.1, U5.1 (BOOT)
unnamed: C42.1, C48.1, U5.6 (COMP)
unnamed: C49.1, U5.4 (SS)
unnamed: C41.1, U6.1 (BOOT)
unnamed: C43.1, C50.1, U6.6 (COMP)
unnamed: C51.1, U6.4 (SS)
unnamed: C53.2, R24.2, R28.1, U8.5 (FB)
unnamed: L3.1, U8.3 (SW)
unnamed: C59.2, R34.2, R37.1, U9.5 (FB)
unnamed: L4.1, U9.3 (SW)

Notes on the sheet:
>=1.2V
Analog supply
USB regulator (5V)
Main regulator (3.3V)
>=1.25V
VDD-CORE/SYS (0.9V)
VCC-DRAM (1.5V)
~3.9V UVLO
PMOS Vgs>6V
Main fuse
Vref = 0.8V 5.16V = 2.2k / 12k 5.16V = 3.3k / 18k
Power switch
Always ON
Vref = 0.6V 1.50V = 22k / 33k 1.50V = 100k / 150k
Vref = 0.8V 3.22V = 3.3k / 10k 3.27V = 2.2k / 6.8k 3.31V = 1.5k / 4.7k 3.35V = 4.7k / 15k
~6.5 ms
+12VSB ADC
Vref = 0.6V 0.88V = 47k / 22k 0.89V = 68k / 33k 0.91V = 47k / 24k
