kuba2k2/PiVI/hardware/PiVI.kicad_pcb

## KiCad design hardware/PiVI.kicad_pcb (continued)

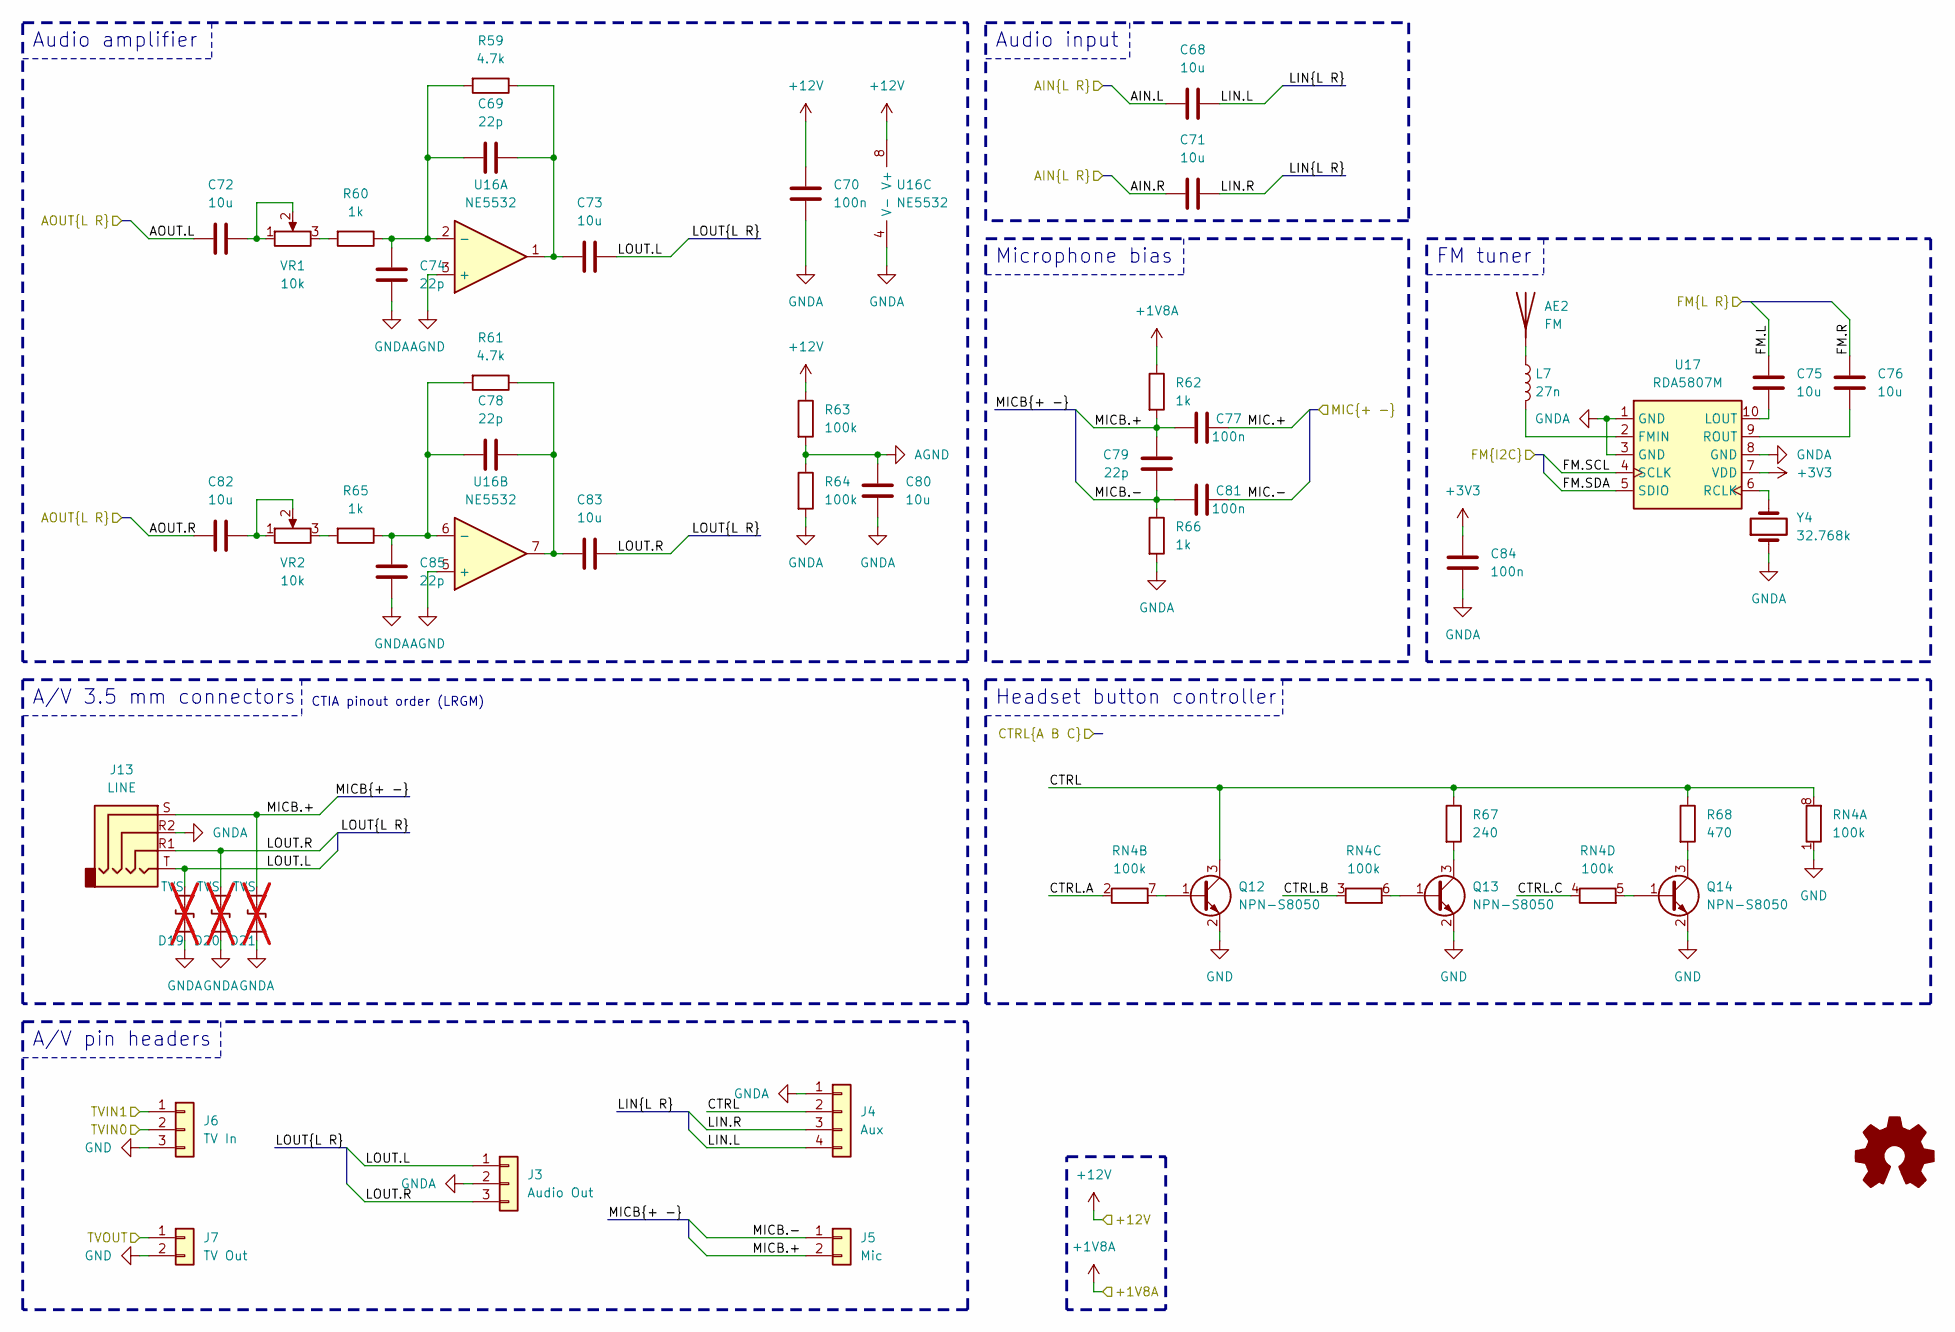
[picture p10: schematic PiVI_AV.kicad_sch, PiVI]

Parts:
AE2: FM; TestPoint_Pad_D1.5mm; MPN N/A
C68, C71, C72, C73, C75, C76, C80, C82, C83: 10u; C_0603_1608Metric; MPN C19702
C69, C74, C78, C79, C85: 22p; C_0603_1608Metric; MPN C105620
C70, C77, C81, C84: 100n; C_0603_1608Metric; MPN C14663
D19, D20, D21: TVS; D_SOD-523; MPN C3008120; not fitted
J3: Audio Out; JST_PH_S3B-PH-K_1x03_P2.00mm_Horizontal; MPN C157929
J4: Aux; JST_PH_B4B-PH-K_1x04_P2.00mm_Vertical; MPN C131334
J5: Mic; JST_PH_B2B-PH-K_1x02_P2.00mm_Vertical; MPN C131337
J6: TV In; JST_PH_B3B-PH-K_1x03_P2.00mm_Vertical; MPN C131339
J7: TV Out; JST_PH_B2B-PH-K_1x02_P2.00mm_Vertical; MPN C131337
J13: LINE; Jack_3.5mm_PJ320D_Horizontal; MPN C431535
L7: 27n; L_0603_1608Metric; MPN C12100
Q12, Q13, Q14: NPN-S8050; SOT-23; MPN C181158
R59, R61: 4.7k; R_0603_1608Metric; MPN C2907166
R60, R62, R65, R66: 1k; R_0603_1608Metric; MPN C2907113
R63, R64: 100k; R_0603_1608Metric; MPN C2907088
R67: 240; R_0603_1608Metric; MPN C2907130
R68: 470; R_0603_1608Metric; MPN C2907172
RN4: 100k; R_Array_Convex_4x0603; MPN C173315
U16: NE5532; SOIC-8_3.9x4.9mm_P1.27mm; MPN C7426
U17: RDA5807M; MSOP-10_3x3mm_P0.5mm
VR1, VR2: 10k; Potentiometer_Bourns_3296W_Vertical; MPN C118954
Y4: 32.768k; Crystal_SMD_3215-2Pin_3.2x1.5mm; MPN C5361379

Connections:
+1V8A: R62.1; also elsewhere on the board
+3V3: C84.1, U17.7 (VDD); also elsewhere on the board
+12V: C70.1, R63.1, U16.8 (V+); also elsewhere on the board
/AV/AIN.L: C68.1; also elsewhere on the board
/AV/AIN.R: C71.1; also elsewhere on the board
/AV/AOUT.L: C72.1; also elsewhere on the board
/AV/AOUT.R: C82.1; also elsewhere on the board
/AV/CTRL: J4.2, Q12.3 (C), R67.1, R68.1, RN4.8 (R1.2)
/AV/CTRL.A: RN4.2 (R2.1); also elsewhere on the board
/AV/CTRL.B: RN4.3 (R3.1); also elsewhere on the board
/AV/CTRL.C: RN4.4 (R4.1); also elsewhere on the board
/AV/LIN.L: C68.2, J4.4
/AV/LIN.R: C71.2, J4.3
/AV/LOUT.L: C73.2, D19.1 (A1), J3.1, J13.T
/AV/LOUT.R: C83.2, D20.1 (A1), J3.3, J13.R1
/AV/MIC.+: C77.2; also elsewhere on the board
/AV/MIC.-: C81.2; also elsewhere on the board
/AV/MICB.+: C77.1, C79.1, D21.1 (A1), J5.2, J13.S, R62.2
/AV/MICB.-: C79.2, C81.1, J5.1, R66.1
/FMIN.L: C75.1; also elsewhere on the board
/FMIN.R: C76.1; also elsewhere on the board
/TVIN0: J6.2; also elsewhere on the board
/TVIN1: J6.1; also elsewhere on the board
/TVOUT0: J7.1; also elsewhere on the board
AGND: C80.1, R63.2, R64.1, U16.3 (+), U16.5 (+); also elsewhere on the board
GND: J6.3, J7.2, Q12.2 (E), Q13.2 (E), Q14.2 (E), RN4.1 (R1.1); also elsewhere on the board
GNDA: C70.2, C74.2, C80.2, C84.2, C85.2, D19.2 (A2), D20.2 (A2), D21.2 (A2), J3.2, J4.1, J13.R2, R64.2, R66.2, U16.4 (V-), U17.1 (GND), U17.3 (GND), U17.8 (GND), Y4.1; also elsewhere on the board
unnamed: AE2.1 (A), L7.1
unnamed: C69.2, C73.1, R59.1, U16.1
unnamed: C72.2, VR1.1, VR1.2
unnamed: C78.2, C83.1, R61.1, U16.7
unnamed: C82.2, VR2.1, VR2.2
unnamed: Q12.1 (B), RN4.7 (R2.2)
unnamed: Q13.1 (B), RN4.6 (R3.2)
unnamed: Q13.3 (C), R67.2
unnamed: Q14.1 (B), RN4.5 (R4.2)
unnamed: Q14.3 (C), R68.2
unnamed: R60.2, VR1.3
unnamed: R65.2, VR2.3
unnamed: C69.1, C74.1, R59.2, R60.1, U16.2 (-)
unnamed: C78.1, C85.1, R61.2, R65.1, U16.6 (-)
unnamed: L7.2, U17.2 (FMIN)
unnamed: C75.2, U17.10 (LOUT)
unnamed: U17.6 (RCLK), Y4.2
unnamed: C76.2, U17.9 (ROUT)

Notes on the sheet:
CTIA pinout order (LRGM)
Audio amplifier
Audio input
FM tuner
Headset button controller
A/V 3.5 mm connectors
A/V pin headers
Microphone bias

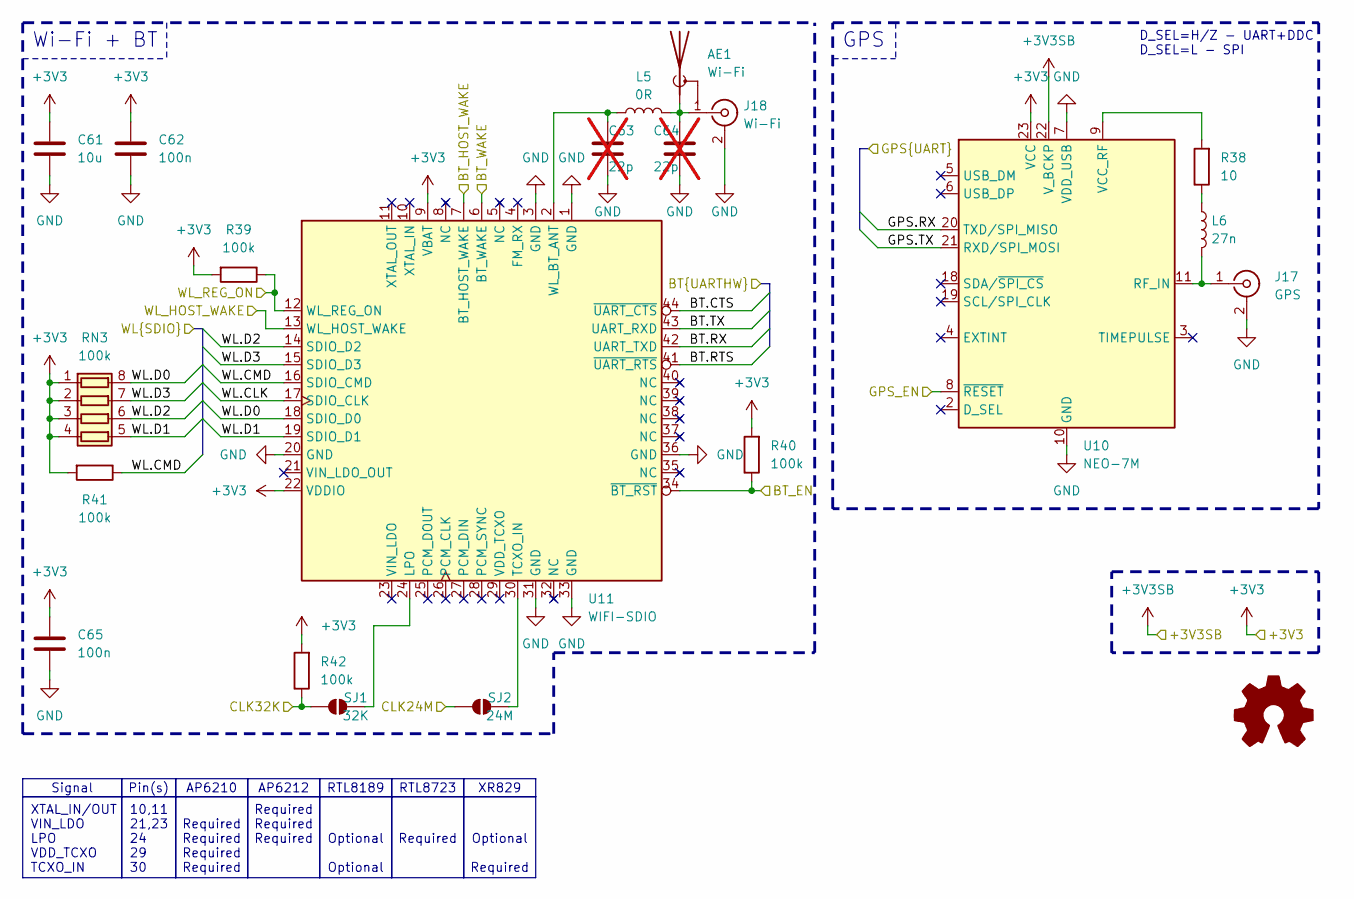
[picture p11: schematic PiVI_Comms.kicad_sch, PiVI]

Parts:
AE1: Wi-Fi; Johanson_2450AT18x100; MPN C127629
C61: 10u; C_0603_1608Metric; MPN C19702
C62, C65: 100n; C_0603_1608Metric; MPN C14663
C63, C64: 22p; C_0603_1608Metric; MPN C105620; not fitted
J17: GPS; U.FL_Hirose_U.FL-R-SMT-1_Vertical; MPN C5137195
J18: Wi-Fi; U.FL_Hirose_U.FL-R-SMT-1_Vertical; MPN C5137195
L5: 0R; L_0603_1608Metric
L6: 27n; L_0603_1608Metric; MPN C12100
R38: 10; R_0805_2012Metric; MPN C2907296
R39, R40, R41, R42: 100k; R_0603_1608Metric; MPN C2907088
RN3: 100k; R_Array_Convex_4x0603; MPN C173315
SJ1: 32K; Jumper_2_NO; MPN N/A
SJ2: 24M; Jumper_2_NO; MPN N/A
U10: NEO-7M; ublox_NEO
U11: WIFI-SDIO; WiFi_SDIO_44-pin

Connections:
+3V3: C61.1, C62.1, C65.1, R39.2, R40.2, R41.2, R42.2, RN3.1 (R1.1), RN3.2 (R2.1), RN3.3 (R3.1), RN3.4 (R4.1), U10.23 (VCC), U11.9 (VBAT), U11.22 (VDDIO); also elsewhere on the board
+3V3SB: U10.22 (V_BCKP); also elsewhere on the board
/AP_CLK24M: SJ2.1 (A); also elsewhere on the board
/AP_CLK32K: R42.1, SJ1.1 (A); also elsewhere on the board
/BT.CTS: U11.44 (~UART_CTS); also elsewhere on the board
/BT.RTS: U11.41 (~UART_RTS); also elsewhere on the board
/BT.RX: U11.42 (UART_TXD); also elsewhere on the board
/BT.TX: U11.43 (UART_RXD); also elsewhere on the board
/BT_EN: R40.1, U11.34 (~BT_RST); also elsewhere on the board
/BT_HOST_WAKE: U11.7 (BT_HOST_WAKE); also elsewhere on the board
/BT_WAKE: U11.6 (BT_WAKE); also elsewhere on the board
/GPS.RX: U10.20 (TXD/SPI_MISO); also elsewhere on the board
/GPS.TX: U10.21 (RXD/SPI_MOSI); also elsewhere on the board
/GPS_EN: U10.8 (~RESET); also elsewhere on the board
/WL.CLK: U11.17 (SDIO_CLK); also elsewhere on the board
/WL.CMD: R41.1, U11.16 (SDIO_CMD); also elsewhere on the board
/WL.D0: RN3.8 (R1.2), U11.18 (SDIO_D0); also elsewhere on the board
/WL.D1: RN3.5 (R4.2), U11.19 (SDIO_D1); also elsewhere on the board
/WL.D2: RN3.6 (R3.2), U11.14 (SDIO_D2); also elsewhere on the board
/WL.D3: RN3.7 (R2.2), U11.15 (SDIO_D3); also elsewhere on the board
/WL_HOST_WAKE: U11.13 (WL_HOST_WAKE); also elsewhere on the board
/WL_REG_ON: R39.1, U11.12 (WL_REG_ON); also elsewhere on the board
GND: C61.2, C62.2, C63.1, C64.1, C65.2, J17.2 (Ext), J18.2 (Ext), U10.7 (VDD_USB), U10.10 (GND), U10.12 (GND), U10.13 (GND), U10.24 (GND), U11.1 (GND), U11.3 (GND), U11.20 (GND), U11.31 (GND), U11.33 (GND), U11.36 (GND); also elsewhere on the board
unnamed: AE1.1 (A), C64.2, J18.1 (In), L5.2
unnamed: J17.1 (In), L6.2, U10.11 (RF_IN)
unnamed: L6.1, R38.1
unnamed: SJ1.2 (B), U11.24 (LPO)
unnamed: SJ2.2 (B), U11.30 (TCXO_IN)
unnamed: R38.2, U10.9 (VCC_RF)
unnamed: C63.2, L5.1, U11.2 (WL_BT_ANT)

Notes on the sheet:
RTL8723
AP6210
XR829
Required
Required Required Required Required
Pin(s)
10,11 21,23 24 29 30
Signal
XTAL_IN/OUT VIN_LDO LPO VDD_TCXO TCXO_IN
Required Required Required
AP6212
Optional Required
RTL8189
Optional Optional
Wi-Fi + BT
D_SEL=H/Z - UART+DDC D_SEL=L - SPI
GPS

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
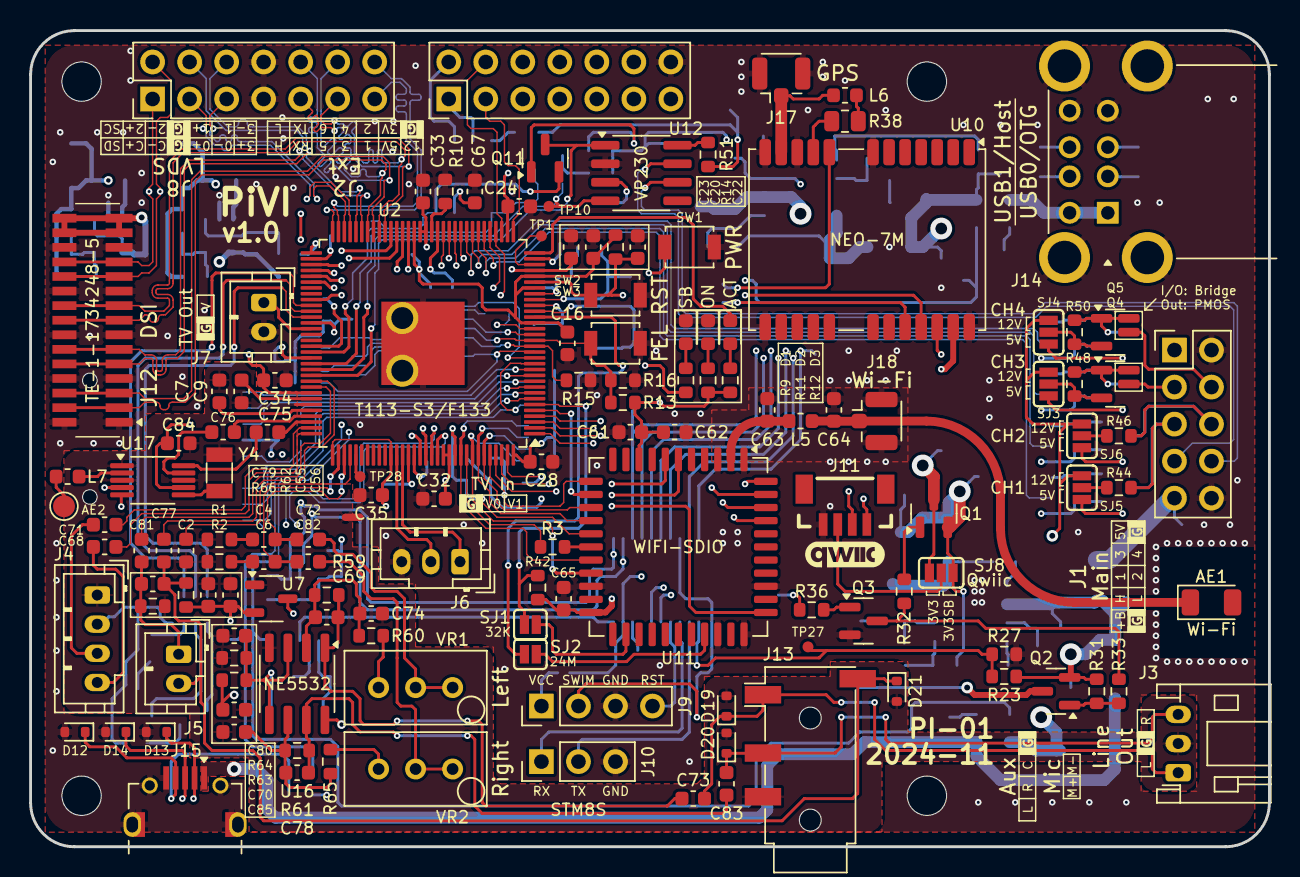
[picture p12: board PiVI.kicad_pcb from above]

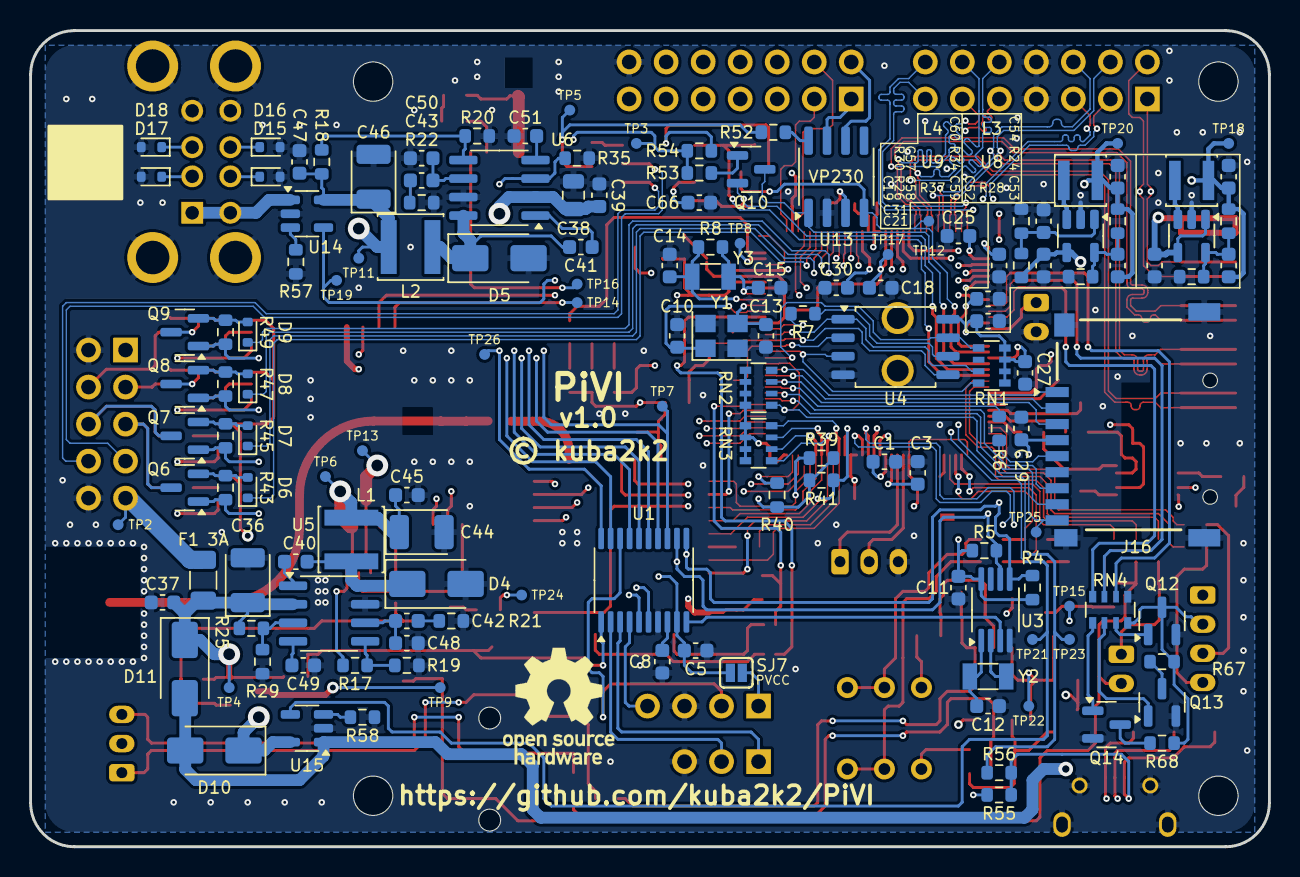
[picture p13: board PiVI.kicad_pcb from below]

Board: 4 copper layers, 85.0 x 56.0 mm, 289 parts (147 on the bottom side), 215 nets.
