kuba2k2/PiVI/(notices)

Notices in the files:
hardware/PiVI.kicad_pcb:
© kuba2k2
